coronax/project65/Schematics/P65_audio_board.pdf

# TE 10 Q3 11 Q2 12 Q1 13 Q0 14 TC 15 VCC 16

## Audio stage: voltage

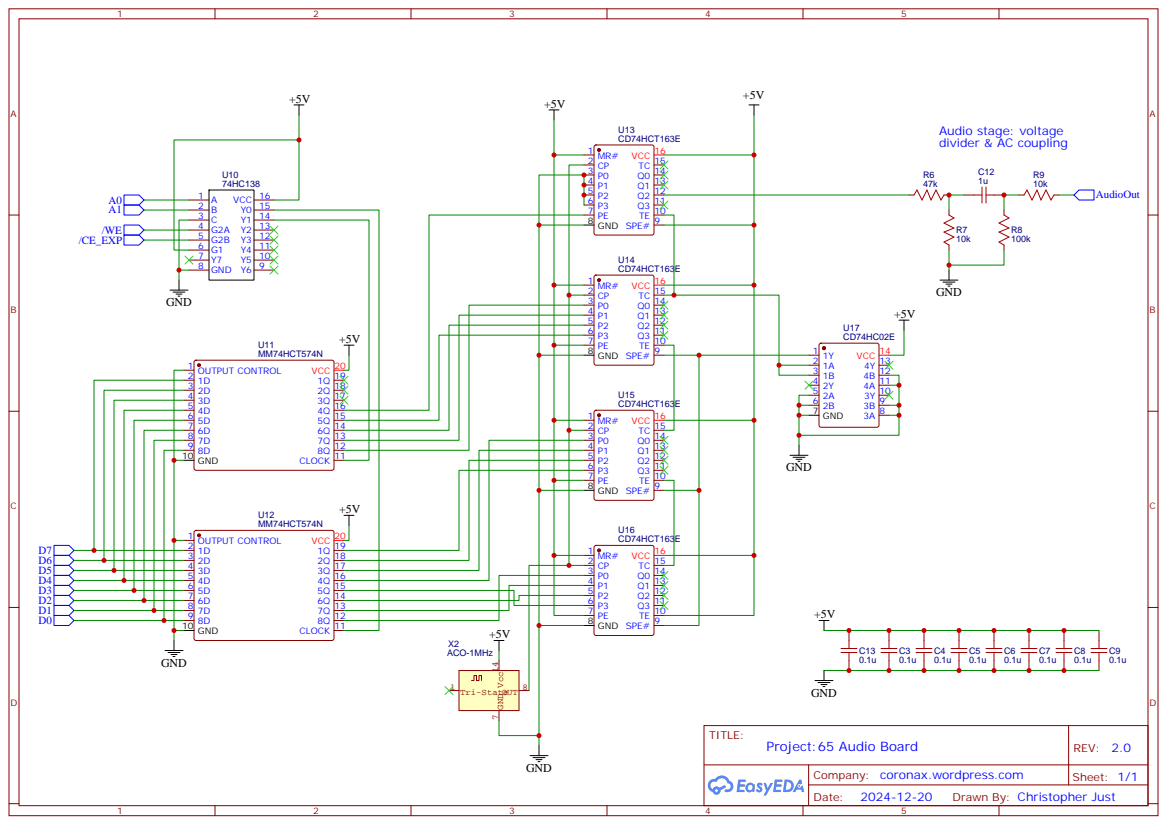
[picture p1: page 1]

Company: coronax.wordpress.com

Drawn By: Christopher Just
