coronax/project65/Schematics/P65_main_board.pdf

## Address Bus

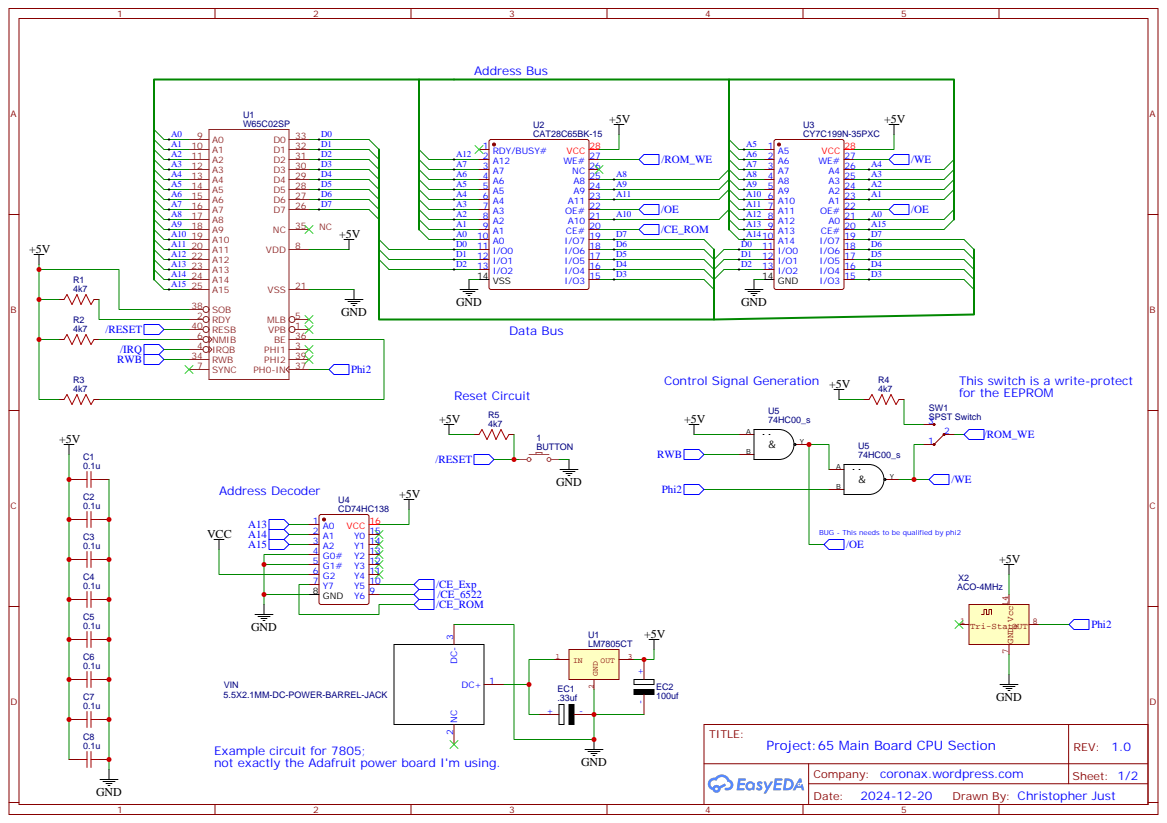
[picture p2: page 1]

BUG - This needs to be qualified by phi2

5.5X2.1MM-DC-POWER-BARREL-JACK

Example circuit for 7805;
not exactly the Adafruit power board I'm using.

Company: coronax.wordpress.com

Drawn By: Christopher Just

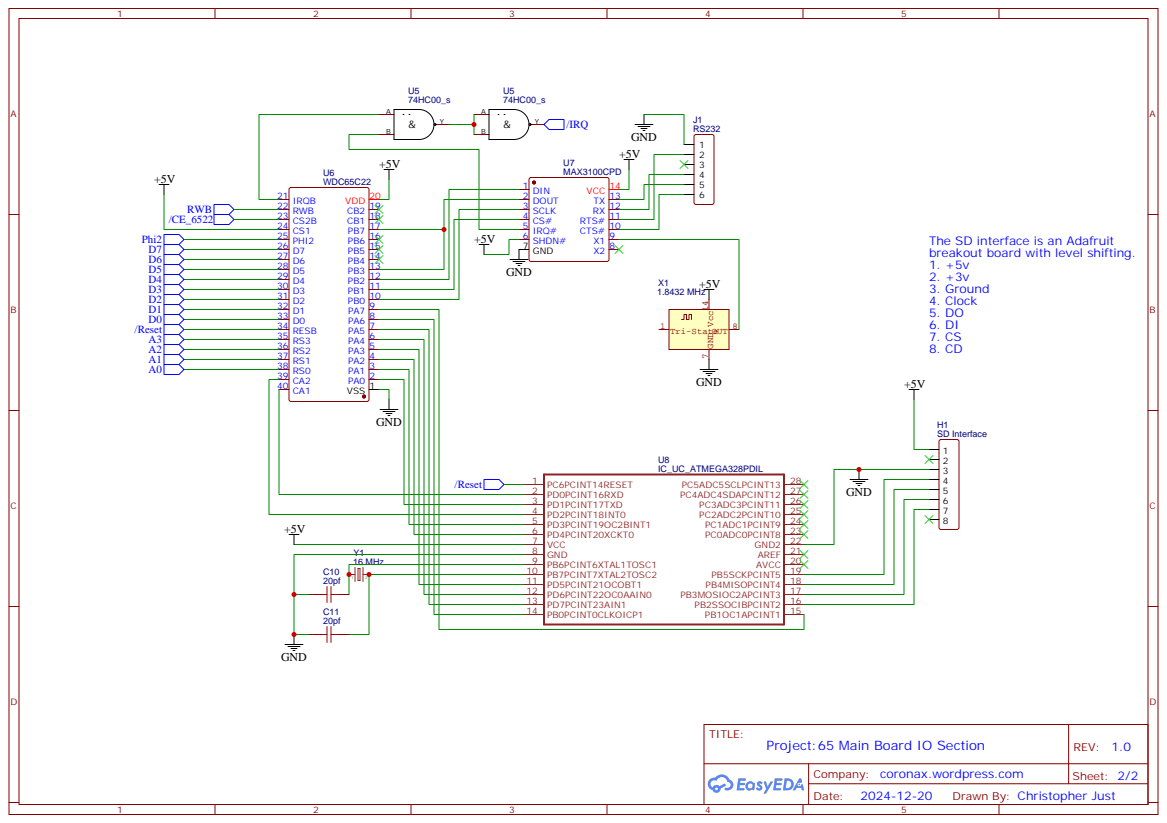
[picture p3: page 2]

Company: coronax.wordpress.com

Drawn By: Christopher Just
