coronax/project65/(commit log)

2024-01-30 Moving P65 OS repo from SVN to Git.
    [p65.cfg]
2024-01-31 Add the expansion board blinkenlights demo code.
    [p65.cfg]
2024-02-24 Add source for the "insitu" firmware updater utility.
    [p65.cfg]
2024-05-16 Updated monitor 'g' command
    The g command now allows an arbitrary # of arguments. Arg 1 is taken as the start address if present, the others are ignored (but can be parsed by the called program).
    The command also now prints the program return code after it terminates.
2024-05-23 Fix a memory leak
    Also made a note that we should refactor to remove dynamic memory usage so this doesn't happen again.
    [DiskController.ino]
2024-05-23 Fix a bug where device open did note set filemode in devtab.
    [SD.asm]
2024-06-16 Add placeholders for DEV_GET_STATUS, DEV_SEEK, and DEV_TELL.
    [p65.cfg]
2024-06-18 Added a skeleton for a TTY device
    This also unfortunately got combined with some function renaming in devtab.
    Updated for devtab function name changes.
2024-06-22 Fix some function names for consistency.
    [IO.asm]
2024-06-27 Add EOF support and max line lengths to tty device.
2024-07-03 Adding ioctl to devtab interface.
    Changing the *_INIT functions to *_IOCTL, where initialization is performed by calling ioctl() with an argument of 0. Other arguments are device specific (right now tty is the only one that has any).
    [p65.cfg]
2024-07-14 Fixed EOF handling error
    When TTY device receives EOF from its input device, it needs to treat that as an end of line, or else the remainder of the last line won't ever be visible to the calling program.
    [tty.asm]
2024-07-15 Rework device return codes
    Reworked device open, close, and ioctl calls to return meaningful error codes with values < 0 on error. The particular values used are equivalent to cc65's errno values ORed with 0x80, so that it's easy for the cc65 standard lib functions like open and close to set errno appropriately.
    [DiskController.ino, IO.asm, Main.asm, SD.asm, devtab.asm, tty.asm]
2024-07-17 Added seek support.
    This required quite a bit of refactoring of the command reader, since seek doesn't send a text string. This has created, or altered the timing to highlight, some kind of syncronization issue that's showing up during some of my read tests. Very peculiar.
    [DiskController.ino]
2024-07-18 Added SD_SEEK. Fixed SD port handshake.
    The P:65 side of the parallel port handshake now explicitly waits for CA1 to go low at the end of a byte transfer before returning from ReadByte or WriteByte. I think this finally resolves some timing-related disk IO errors.
    [DiskController.ino, SD.asm]
2024-08-01 New "ls" support and new error handling.
    - Updated the "ls" handler to use the new directory reader functionality.
    - Added a new generic perror function.
    - Rewrote a bunch of error handling for more, load, and save.
    [Main.asm, tty.asm]
2024-08-05 File handling updates
    - rm and rmdir are now more strict about only removing files and directores, respectively.
    - Added HandleCpFile, which as the name suggests copies a file. It currently has code to insert into a directory if the dest name is a directory, but I'm not sure that wouldn't be better placed in client code.
2024-08-06 Fix a glitch in directory reading that caused EOF to be sent early.
    Had been using a char* buffer, which meant any 0xFF character was sign-extended to 0xffff, which got interpreted as an early EOF.
    [DiskController.ino]
2024-08-10 Adding initial version of P:65 music player program.
    This is basically the Dec 2023 version, and started life as a copy of Insitu.
    As a result of this, it uses a lot of assembly language routines. And needs to be moved over to using the cc65 standard library that we now have.
2024-08-14 kernel external interface changes
    - Added filesystem commands to jump table in vectors.asm. Removed DEV_TELL and the unused space between this table and the 6502 vectors.
    - Changed in-memory structure of realtime clock. Now stores a 4-byte count of seconds as well as a 1-byte count of hundredths of seconds.
    [p65.cfg]
2024-08-16 Trimming unneeded assembly routines
    Audio inherited a bunch of assembly-language routines from insitu that it doesn't really need. Starting to trim this down into a more generally useful program.
    [audio.c, io.asm]
2024-08-18 Renaming print routines for consistency
    Long overdue:
    send_char => _print_char
    read_char => _read_char
    _outputstring => _print_string
    print_hex => _print_hex
2024-08-19 New SD card seek protocol
    - Redid the message format for seek so that it now sends a command string without zeroes and can be parsed the same as everything else.
    - Got rid of the ugly state machine cruft in DiskController.
    - Moved _send_hex to dev_write_hex in devtab.
    - Added a "NOSEEK" dummy function for unseekable devices that follows the return value conventions of a real seek.
    - It turns out that file I/O recover wasn't broken after a bad seek, I just had to clear the FILE*'s error flag on the C side.
    [DiskController.ino, SD.asm, devtab.asm, util.asm]
2024-08-19 Performance improvements for SD_GETC
    Changed the protocol for receiving data from the Arduino so that most characters only require one character send, using escape as an escape character for EOF or NO DATA. It's about 30% faster now.
2024-08-22 Memory usage changes for IO driver
    Concentrated all the max3100/spi variables in one chunk in zero page, and removed a spurious write to an unallocated location.
2024-08-24 Add EhBasic with P:65 customizations
    My previous EhBasic build broke due to recent changes to zero-page usage. Unfortunately, I've had to modify the OS zero page usage again in order to get things working. This also means there will be configuration changes for cc65 programs.
    [p65.cfg]
2024-08-31 Improved handling of too-long commands.
    In the event a command written to the command channel exceeds the buffer length, extra characters are ignored. The first read from the channel returns P65_EINVAL and resets the command channel buffer. This should allow better automatic recovery from the too-long command.
    [DiskController.ino]
2024-09-03 Adding dev_read as a standard device function
    Takes the place of dev_tell, which I didn't need after all.
    It includes a default implementation that just calls dev_getc repeatedly, but device drivers can now add optimized versions.
    [devtab.asm, filesystem.asm]
2024-09-05 Command line now uses TTY device.
    Line editing! yay!
2024-09-07 Added stat().
    Note that it uses cc65's definition of struct stat.
    Because of limitations of the SD library we're using, the stat struct doesn't fill in useful things like the timestamps, which feels unfortunate.
    [p65.cfg]
2024-09-13 Updating audio program to take advantage of new C library.
    Cleanup, use printf etc. where appropriate.
2024-09-13 Bugfixes made while working on audio program.
    - initialize audio to silent at startup.
    - fix TTY device to include a \n at the end of input lines in cooked mode, because fgets() expects it.
    [Main.asm, tty.asm]
2024-09-13 Refactored SD_SEEK (again)
    I think I finally have a version that I like:
    1. The message is sent to the actual file channel, instead of command channel. It's an example of sending a message other than getc/putc, which will come in handy when I get around to read.
    2. The return from the Arduino is an error code followed by 4 byte offset value (only if error is EOK). This simplified a bunch of error handling kludges.
    3. On the Arduino side, it did require adding buffers to all FileIO objects, but that'll actually make sense once I move those to being per-channel.
    [DiskController.ino, SD.asm]
2024-09-14 Change to seek communication
    OK, this is maybe the last one. When sending the response to a seek command, the 6502 is just going to read the result immediately. Since we know this doesn't block or anything, we can just immediately send the result with WriteByte instead of buffering it and requesting it character-by-character.
    [DiskController.ino, SD.asm]
2024-09-14 Shorter version of PrintMemory
    Used some loops to cut out redundant instructions.
    [cmdline.asm]
2024-09-14 Added cls (clear screen) terminal command.
    Also added a ResetTerminal utility function, and call it during the reset loop.
    [Main.asm]
2024-09-14 Added an ioctl to the serial driver to flush the write buffer.
    The resulting code just busy waits counting the write buffer until it hits zero.
2024-09-16 Reserve a couple bytes of zero page for interrupt handlers to use.
2024-09-17 command-line tokenizer updates
    - added support for quote-delimited strings
    - fixed a bug with terminating whitespace being added as a false argument.
    [cmdline.asm]
2024-10-15 Add support for dynamically setting serial port speed.
    - Support for ioctl IO_SER_RATE in serial driver
    - TTY also forwards IO_SER_RATE to serial driver
    - Added a stty program to CUtil for setting baud rate
    - Changed default rate to 19.2k
2024-10-21 Very experimental interrupt-based player.
2024-10-30 Changed note frequency calculations to work with latest schematic revision.
    The audio circuit now uses a 12-bit counter, and we use a higher output from the last counter to shift the frequency range down a couple octaves.
2024-12-09 Make room in vectors table for 65816 interrupt vectors.
    This changes locations in the OS jump table, which means I have to recompile the universe.
    [p65.cfg]
2024-12-21 Add schematics
2025-01-12 Add missing branch in SD_READ
    Somehow the original commit of the SD_READ code was missing one line that I think had to have been in the compiled version that I tested with. No idea how that happened.
    [SD.asm]
2025-01-12 Refactored devtab, added DEFAULT_WRITE and SD_WRITE
    Refactored devtab to make room for the new dev_write device function. Added a default implementation and an optimized version for the SD device.
    [p65.cfg]
2025-01-14 Fix an error in read & write operation size checking.
    Accidentally cleared the top bit of the lower byte, not the upper byte, when limiting the maximum count for read and write ops. Oops.
    [devtab.asm]
2025-02-05 Major performance improvements in SD access times.
    Eliminated dynamic allocations in DiskController.
    Replaced PinMode/DigitalRead/DigitalWrite calls with raw register code.
    This change alone is more than a 2x performance improvement.
    Cleanup
    Buffered reads/writes offer a small performance boost.
    Only available for readonly or writeonly files - files opened with O_RDWR will use unbuffered IO because I don't want to deal with that.
    Remove the file_open variable in FileRW, which was always useless.
    get rid of the interrupt handler, just poll the state of ca2 directly in ReadByte & WriteByte.
    [DiskController.ino, SD.asm, devtab.asm]
